Musa1088/EE464_HardwareProject/LeakageMeasurement.jpeg

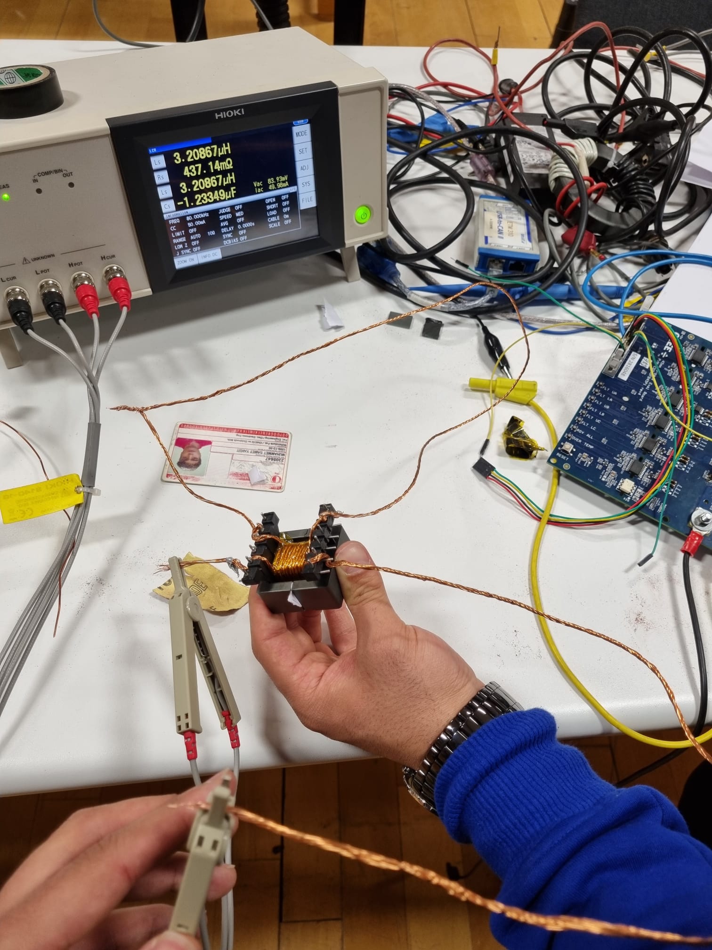
LeakageMeasurement.jpeg
