Musa1088/EE464_HardwareProject/Final Report/LineRegulation24Voutput.jpeg

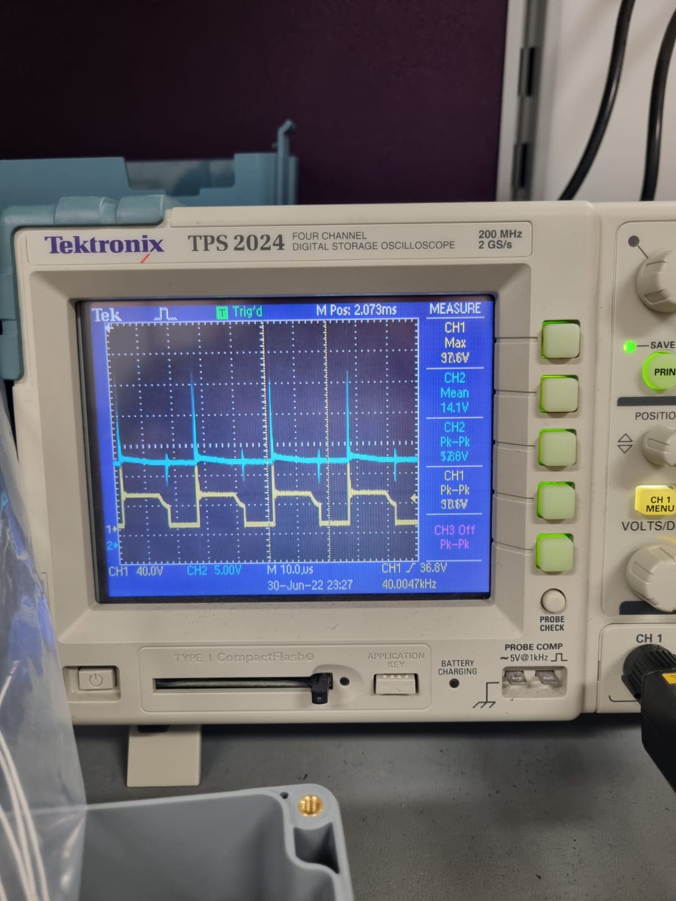
Final Report/LineRegulation24Voutput.jpeg
