Musa1088/EE464_HardwareProject/Controller Options/Capture.PNG

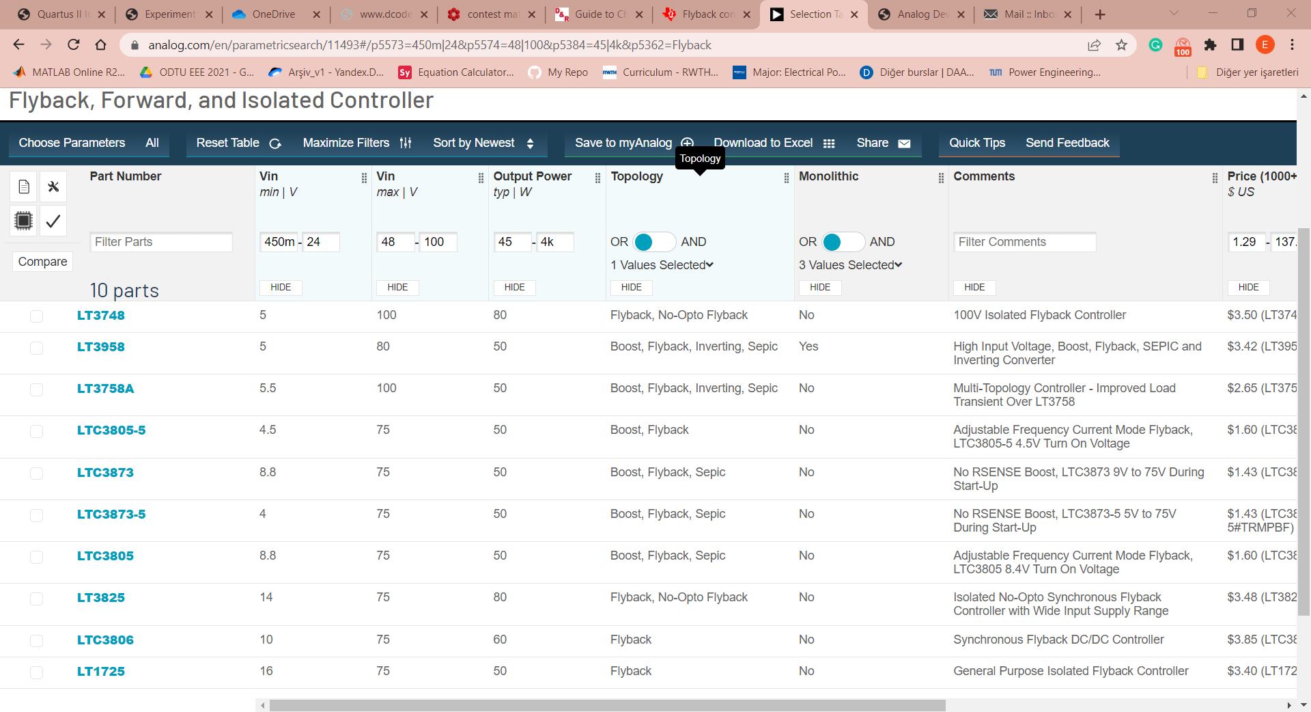
Controller Options/Capture.PNG
