Musa1088/EE464_HardwareProject/Final Report/5ohm24Vinput.jpeg

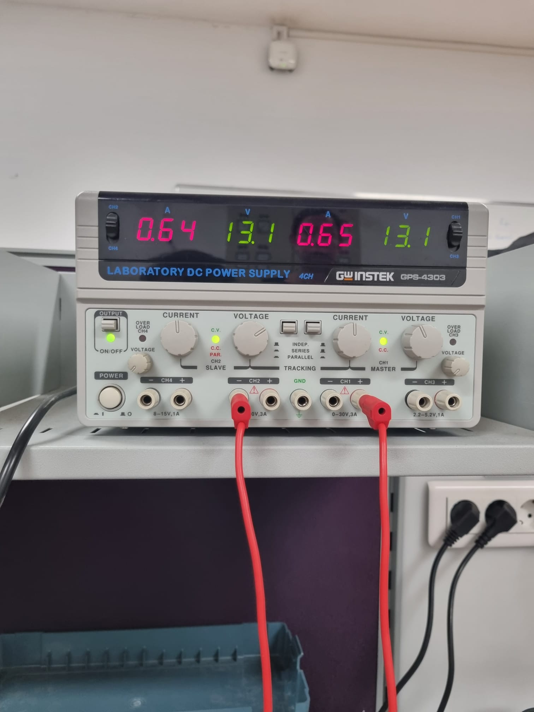
Final Report/5ohm24Vinput.jpeg
