Musa1088/EE464_HardwareProject/Final Report/5ohm24Voutput.jpeg

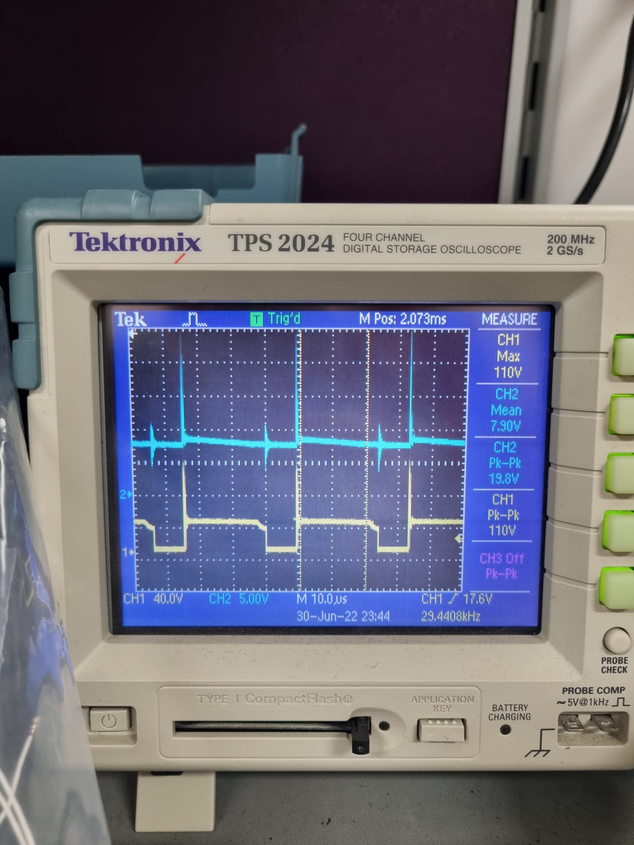
Final Report/5ohm24Voutput.jpeg
