Musa1088/EE464_HardwareProject/Final Report/5ohm48Vinput.jpeg

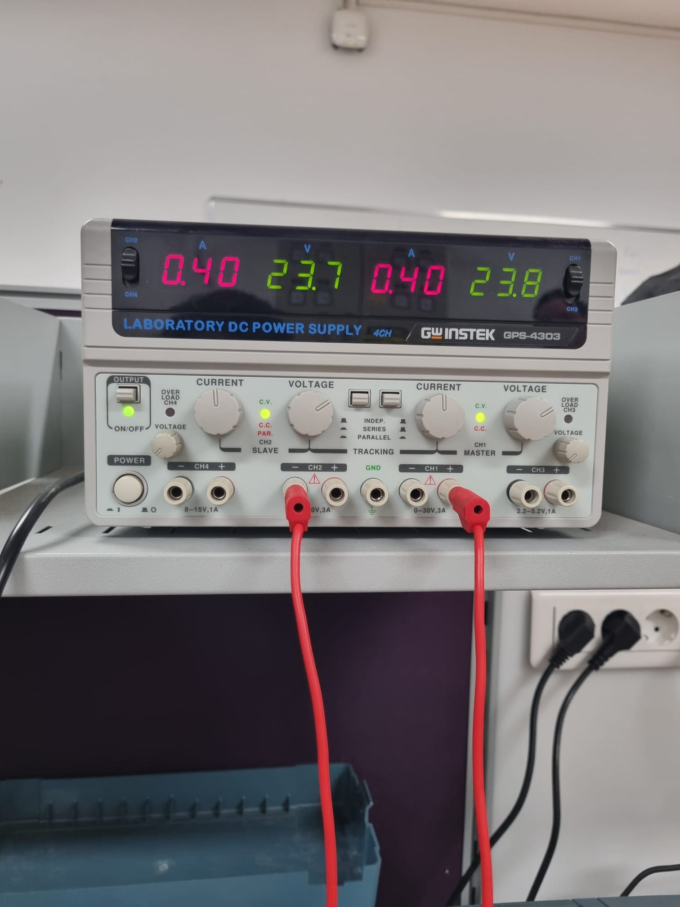
Final Report/5ohm48Vinput.jpeg
