Musa1088/EE464_HardwareProject/Final Report/5ohm48Voutput.jpeg

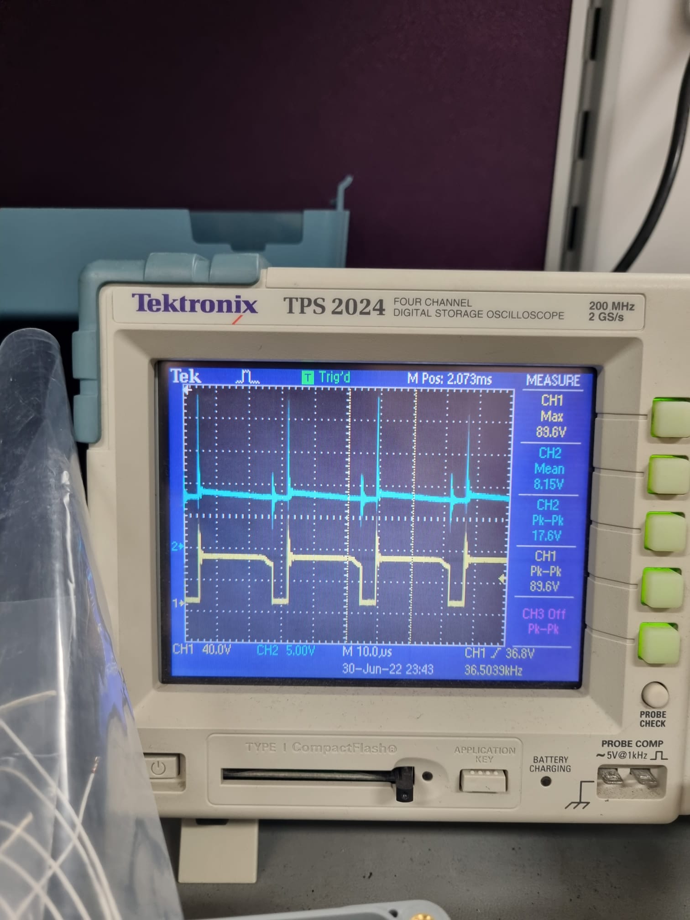
Final Report/5ohm48Voutput.jpeg
