Musa1088/EE464_HardwareProject/Final Report/50ohm24Voutput.jpeg

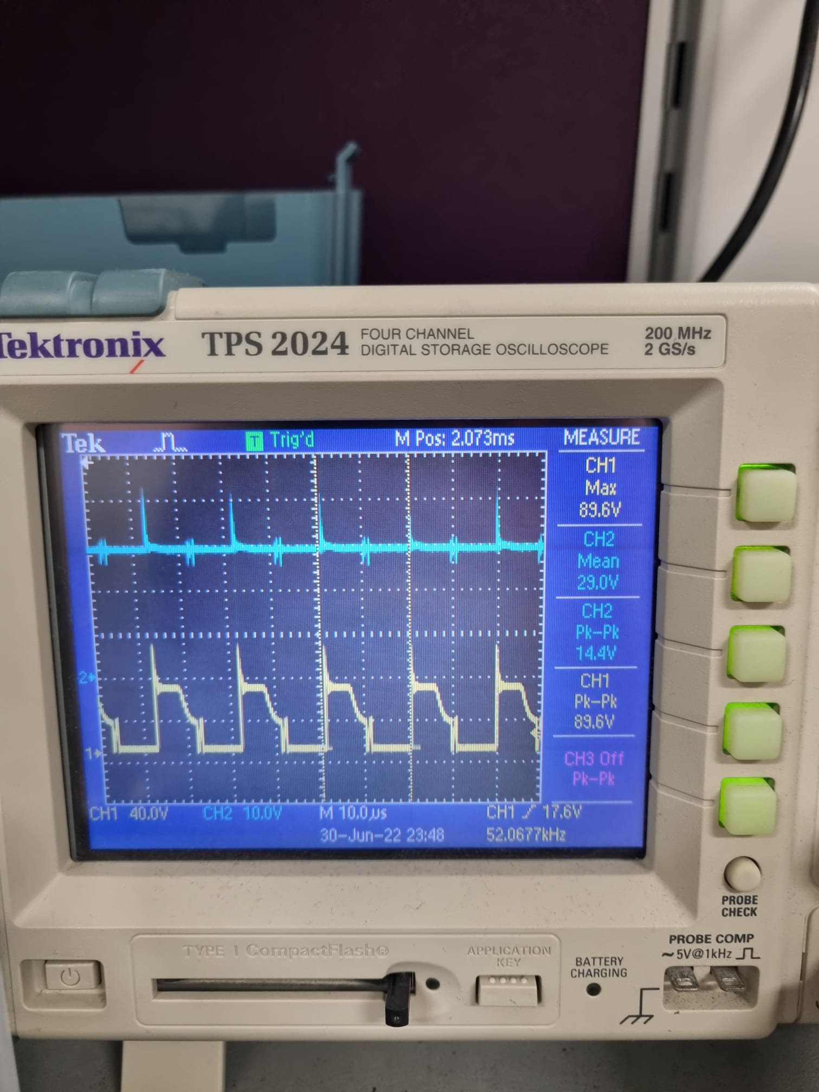
Final Report/50ohm24Voutput.jpeg
