Musa1088/EE464_HardwareProject/Final Report/50ohm48Vinput.jpeg

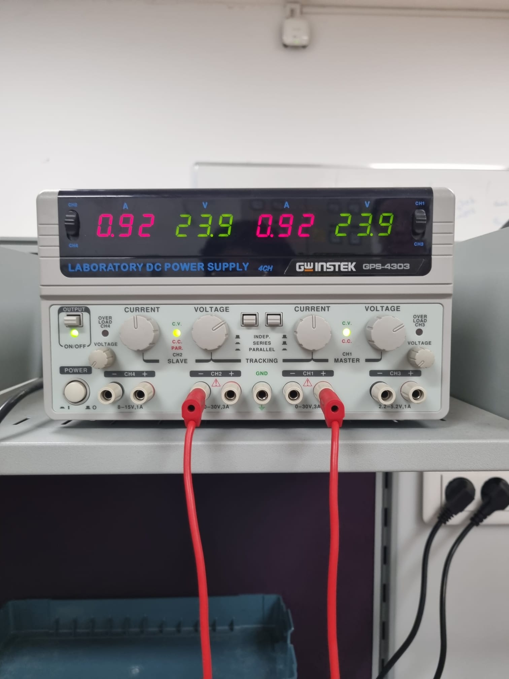
Final Report/50ohm48Vinput.jpeg
