Musa1088/EE464_HardwareProject/Final Report/controller&snubber.jpeg

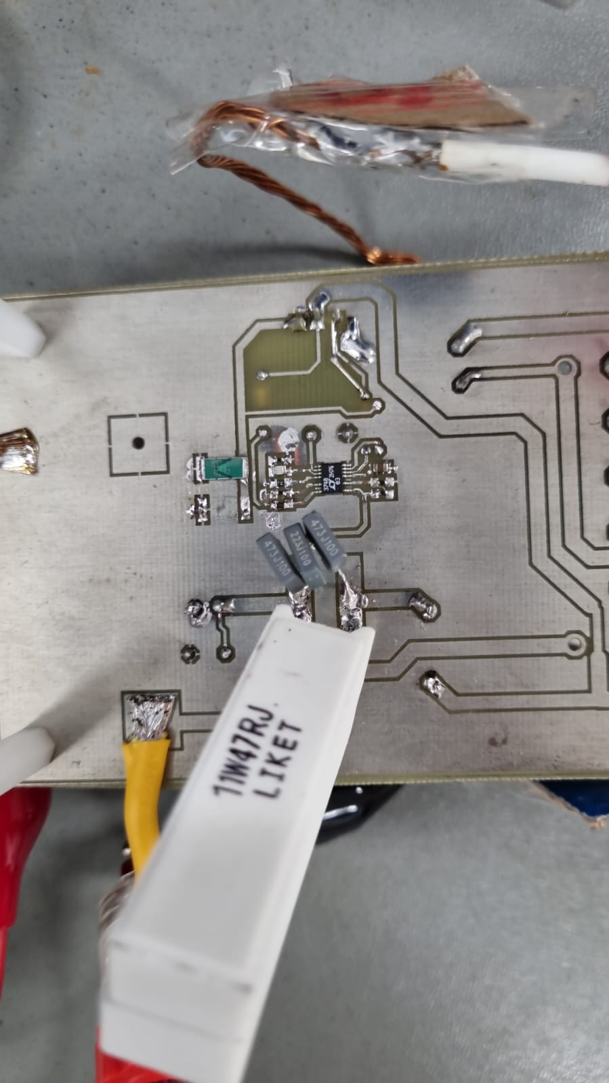
Final Report/controller&snubber.jpeg
