Musa1088/EE464_HardwareProject/Final Report/LineRegulation24VInput.jpeg

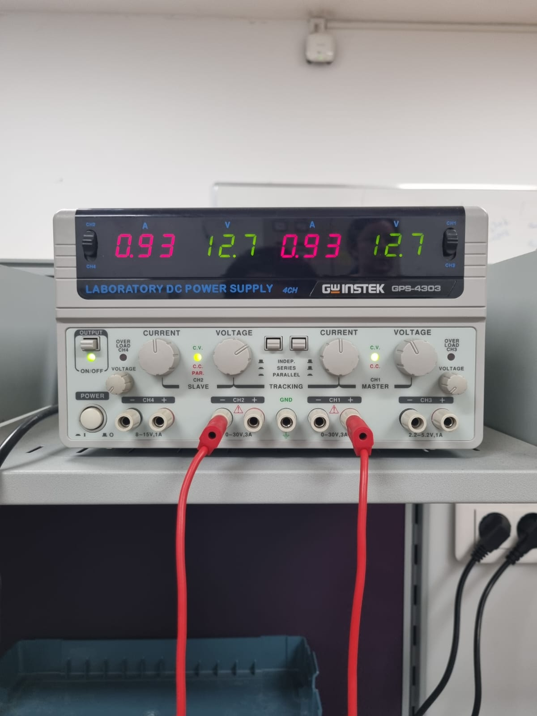
Final Report/LineRegulation24VInput.jpeg
