Musa1088/EE464_HardwareProject/Final Report/LineRegulation48VInput.jpeg

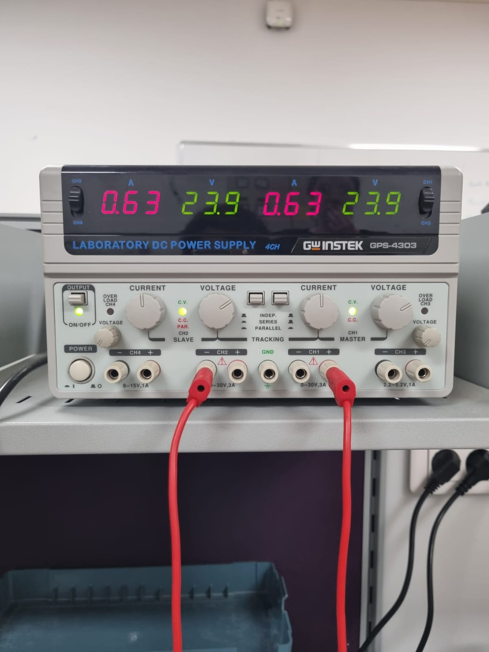
Final Report/LineRegulation48VInput.jpeg
