Musa1088/EE464_HardwareProject/Final Report/LineRegulation48Voutput.jpeg

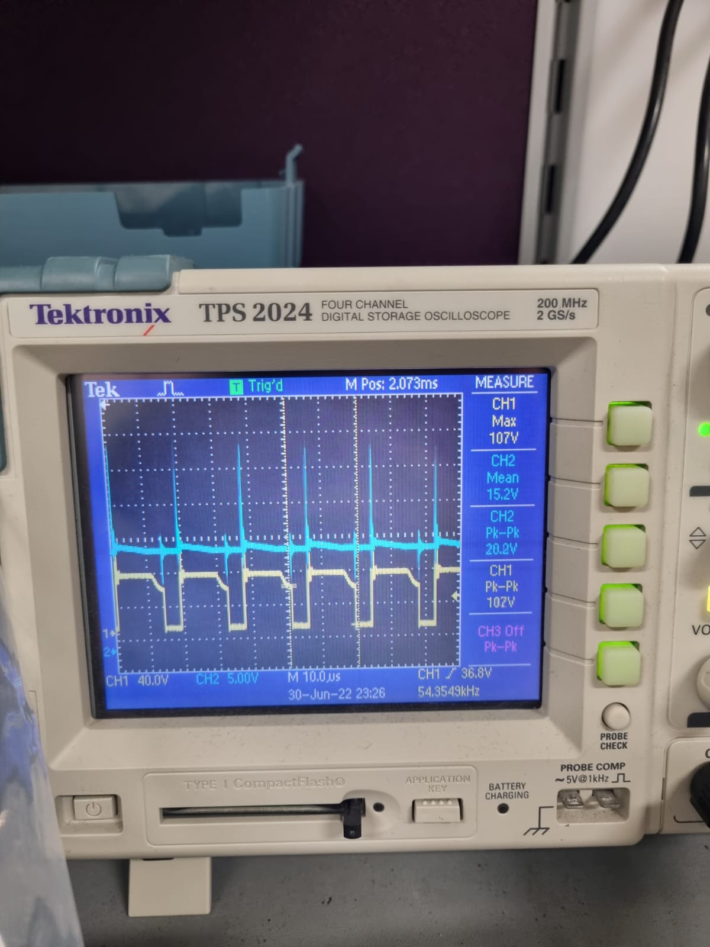
Final Report/LineRegulation48Voutput.jpeg
