Musa1088/EE464_HardwareProject/LeakageInductance.jpeg

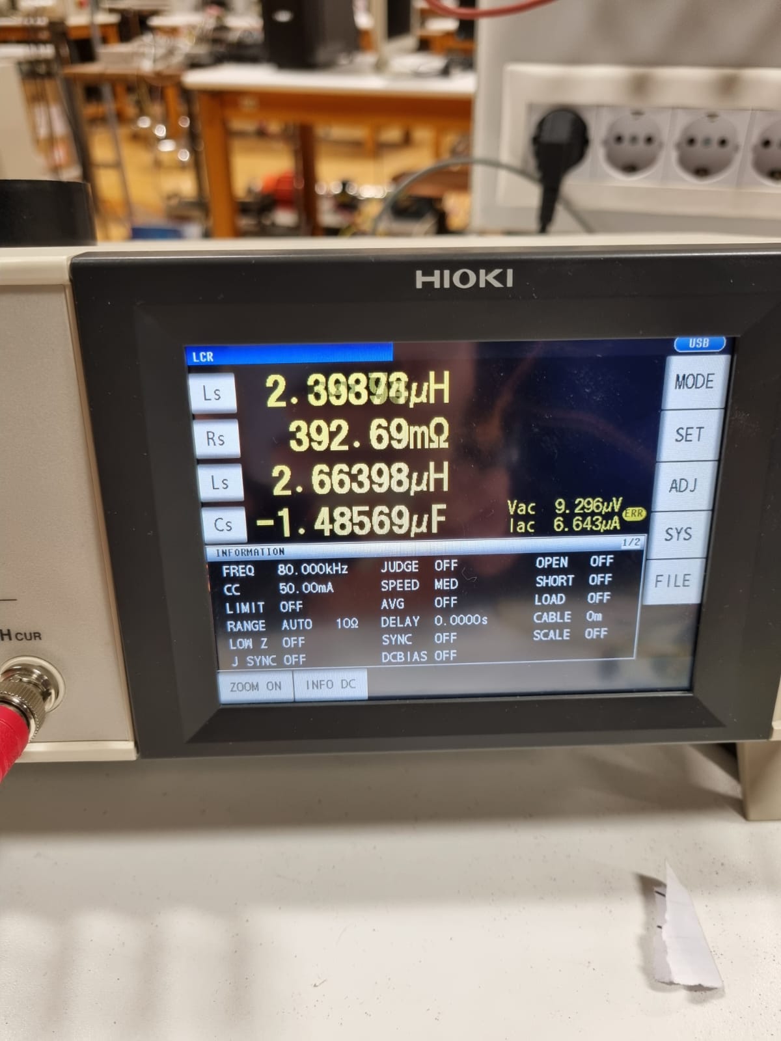
LeakageInductance.jpeg
