Musa1088/EE464_HardwareProject/Ltspice simulations for different controllers/LT3751-design.asc

C1: cap; 120µ
C2: cap; 10n
D1: diode; MUR460
L1: ind2; 20µ; Rser=15m
L2: ind2; 10.2µ
Q1: nmos; IRFP4668
R1: res; 40.2K
R2: res; 18.2K
R3: res; 40k
R4: res; 2.5m
R5: res; 2k
R6: res; 450k
R7: res; 940k
R8: res; 450k
R9: res; 940k
R10: res; 100K
R11: res; 100K
R13: res; 100470
R14: res; 10k
U1: LT3751
V1: voltage; 48
V2: voltage; PWL(.1m 0 .101m 5)
Named nets: 0, IN, OUT
K1 L1 L2 1
.tran .1 startup
