Musa1088/EE464_HardwareProject/Ltspice simulations for different controllers/1241.asc

C1: cap; 500p
C2: cap; .1µ
C3: cap; .01µ
C4: cap; .0022µ
C5: cap; 100p
C6: cap; 22µ
C7: cap; 470p
C8: cap; 3.3µ; Rser=.1
C9: polcap; 3.3µ; Rser=.1
D1: schottky; BAT54
D2: schottky; BAT54
D3: schottky; MBRS340
D4: zener; BZX84C15L
D5: diode; MURS320
L1: ind2; 16µ; Rser=.05 Rpar=2K
L2: ind2; 18.8µ; Rser=.1
L3: ind2; 100µ; Rser=.05 Rpar=5K
L4: ind; 1µ
Q1: NMOS; Si7802DN
R1: RES; .67
R2: res; 200K
R3: res; 13K
R4: res; 25k
R5: res; 1K
R6: res; 12
R7: res; 152K
R8: res; 39
R9: res; 1.32Meg
R10: res; 10K
R11: res; 750
R12: res; 510
R13: res; 400K
Rload: res; 50
U1: LT1241
V1: VOLTAGE; 200
Named nets: 0, +20V, IN
.tran 2m
K1 L1 L2 L3 .98
