Musa1088/EE464_HardwareProject/Ltspice simulations for different controllers/1737.asc

C1: cap; 100p
C2: cap; 1n
C3: cap; .1µ
C4: cap; 20µ; Rser=.1
D1: schottky; 1N5817
L1: ind2; 20µ; Rpar=5K
L2: ind2; 10.4µ; Rpar=5K
L3: ind2; 5µ; Rpar=5K
Q1: NMOS; Si4410DY
R1: RES; .1
R2: res; 100k
R3: res; 100K
R4: res; 100K
R5: res; 100K
R6: res; 5k
R7: res; 100
Rload: res; 10
U1: LT1737
V1: VOLTAGE; 16
Named nets: 0, OUT, IN
K1 L1 L2 L3 1
.tran 1.5m startup
