Musa1088/EE464_HardwareProject/Ltspice simulations for different controllers/3805.asc

C1: cap; 300µ; Rser=10m
C2: cap; 10µ
C3: cap; .0047µ
C4: cap; .01µ
D1: schottky; 1N5817
L1: ind2; 25µ; Rser=.01 Cpar=1p
L2: ind2; 15µ; Rser=1m Cpar=2p
Q1: nmos; Si4848DY
R1: res; 0.0062
R2: res; 6.8K
R3: res; 2000k
R4: res; 110k
R5: res; 56K
R6: res; 100k
R7: res; 10k
R8: res; 118K
Rload: res; 5; pwr=12
U1: LTC3805
V1: voltage; 48
Named nets: 0, OUT, IN
K1 L1 L2 1
.tran 30ms startup
