Musa1088/EE464_HardwareProject/Ltspice simulations for different controllers/8316.asc

C1: cap; 4.7µ
C2: cap; 1200µ; Rser=50m
C3: cap; 47p; Rser=10K
C5: cap; 4.7µ
C7: cap; 90p; Rser=25
C8: cap; 100µ; Rser=2m
C9: cap; 100n; Rser=20K
D1: schottky; RB058L150
D2: schottky; RB058L150
D4: diode; RFN1L7S
D5: zener; 1N5378B; N=2
L1: ind2; 20µ; Rser=0.5
L2: ind2; 10.2µ; Rser=0.03 Cpar=0.5p
L3: ind2; 10.2µ; Rser=0.6
M1: NMOS; STW11NM80
R4: res; 108K
R5: res; 1000k
R6: res; 4.99K
R9: res; 61.9K
Rload: res; 5
Rsense: res; 40m
U1: LT8316
Vin: voltage; 24
Named nets: 0, IN, OUT
K1 L1 L2 L3 1
1.4:1:1
.tran 1 startup
