Musa1088/EE464_HardwareProject/Ltspice simulations for different controllers/LT3748_updated.asc

C1: cap; 4.7n
C2: cap; 4.7µ
C3: cap; 100µ
C4: cap; 2n
D1: schottky; 30BQ060
L1: ind2; 55µ; Rpar=5K
L2: ind2; 33µ; Rpar=5K
Q1: nmos; Si4490DY
R1: res; 56.2K
R2: res; 100k
R3: res; 6.1k
R4: res; 10K
R5: res; 278k
R6: res; 15.4K
R7: res; 11m
Rload: res; 5
U1: LT3748
V1: voltage; 24
Named nets: 0, IN, OUT
K1 L1 L2 1
.tran 25m startup
