Musa1088/EE464_HardwareProject/(list of files, drawings)

Other design files:
Controller Options/SpiceModels/snvmbv9f/LM5156-Q1_PSPICE_TRANS/LM5156-Q1_TRANS.opj
Controller Options/SpiceModels/snvmbv9f/LM5156-Q1_PSPICE_TRANS/LM5156-Q1DSS_TRANS.OLB
PCB design/lt3748.pdsprj
PCB design/Project Backups/lt3748 [20220606, 16-17-19].pdsprj
