Musa1088/EE464_HardwareProject/(commit log)

2022-05-15 spice model
    [LM5156-Q1DSS_TRANS.OLB, LM5156-Q1_TRANS.opj]
2022-05-15 Magnetic design finito
2022-05-15 output capacitor
2022-06-06 initial design for PCB
    [lt3748 [20220606, 16-17-19].pdsprj, lt3748.pdsprj]
2022-06-20 design updated
    [lt3748.pdsprj]
